jamesorry/WiseTech-Dormitory_Manage_System/README.md

# WiseTech-Dormitory_Manage_System
鴻績-宿舍管理系統
