jamesorry/WiseTech-Dormitory_Manage_System/doc/1637031387367.jpg

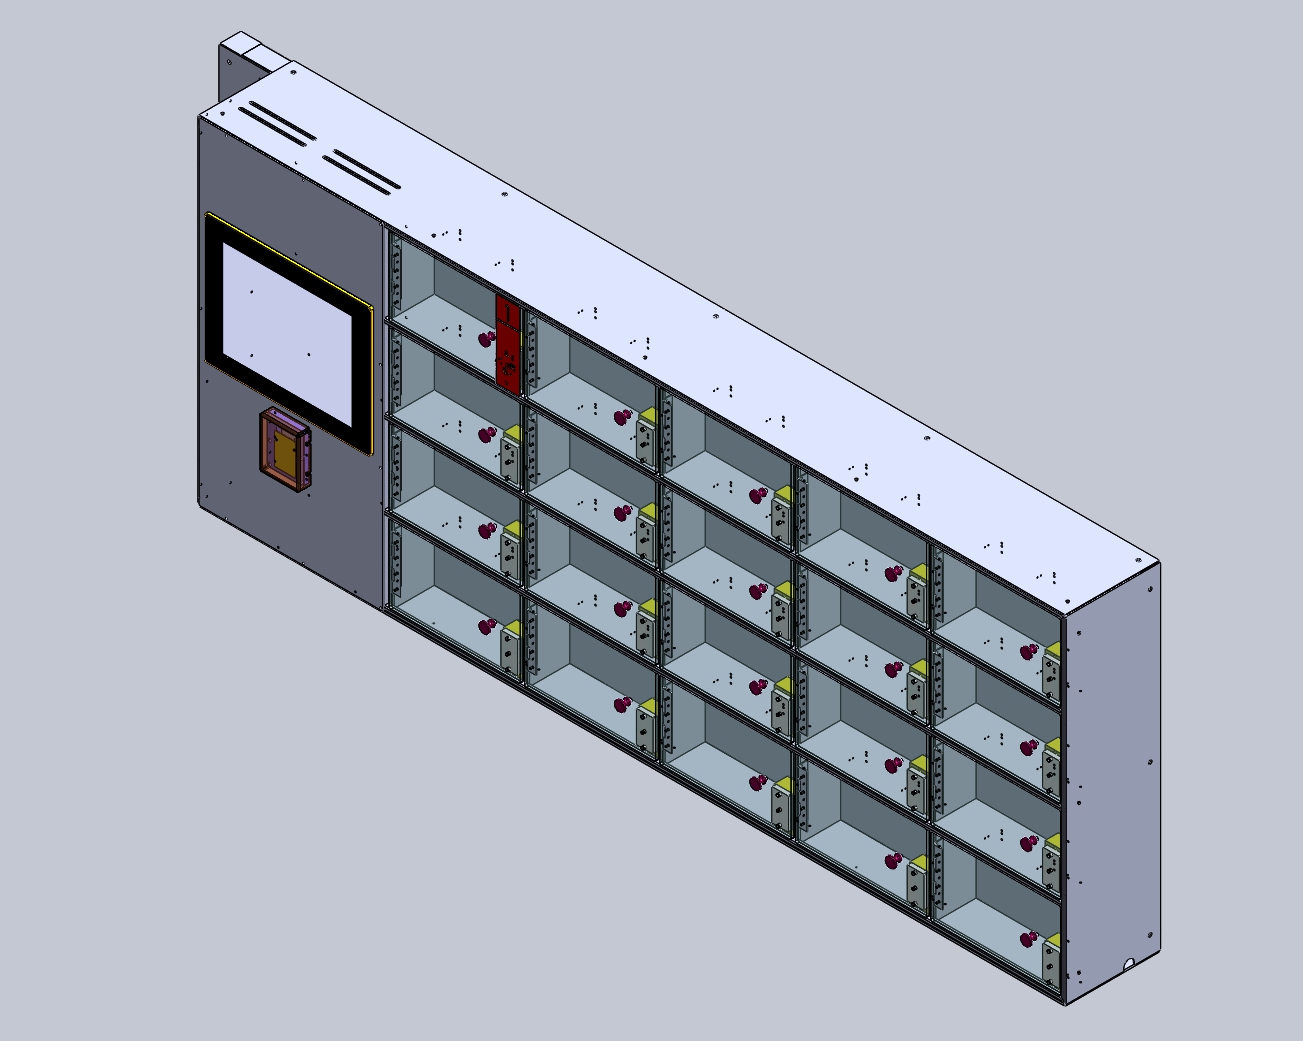
doc/1637031387367.jpg
