jamesorry/WiseTech-Dormitory_Manage_System/doc/1637031412249.jpg

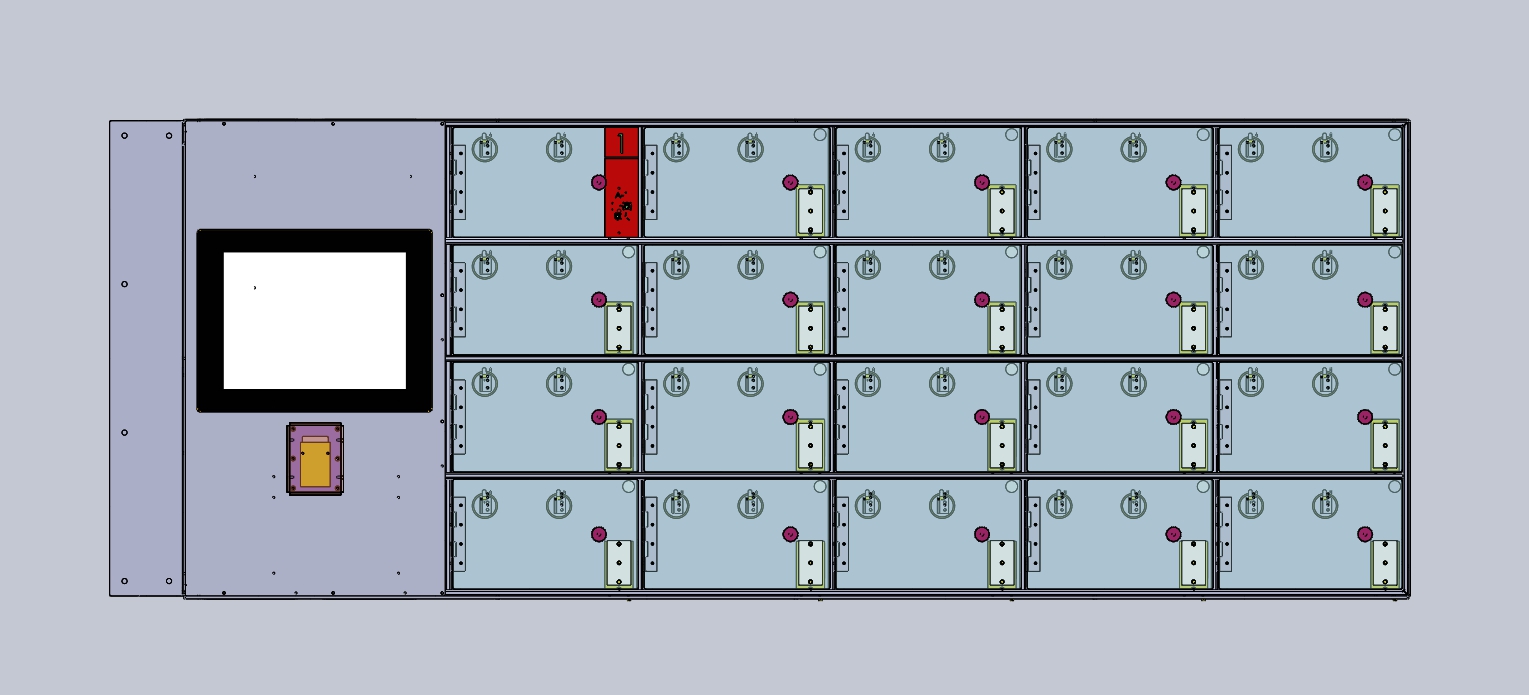
doc/1637031412249.jpg
