jamesorry/WiseTech-Dormitory_Manage_System/doc/1637031450230.jpg

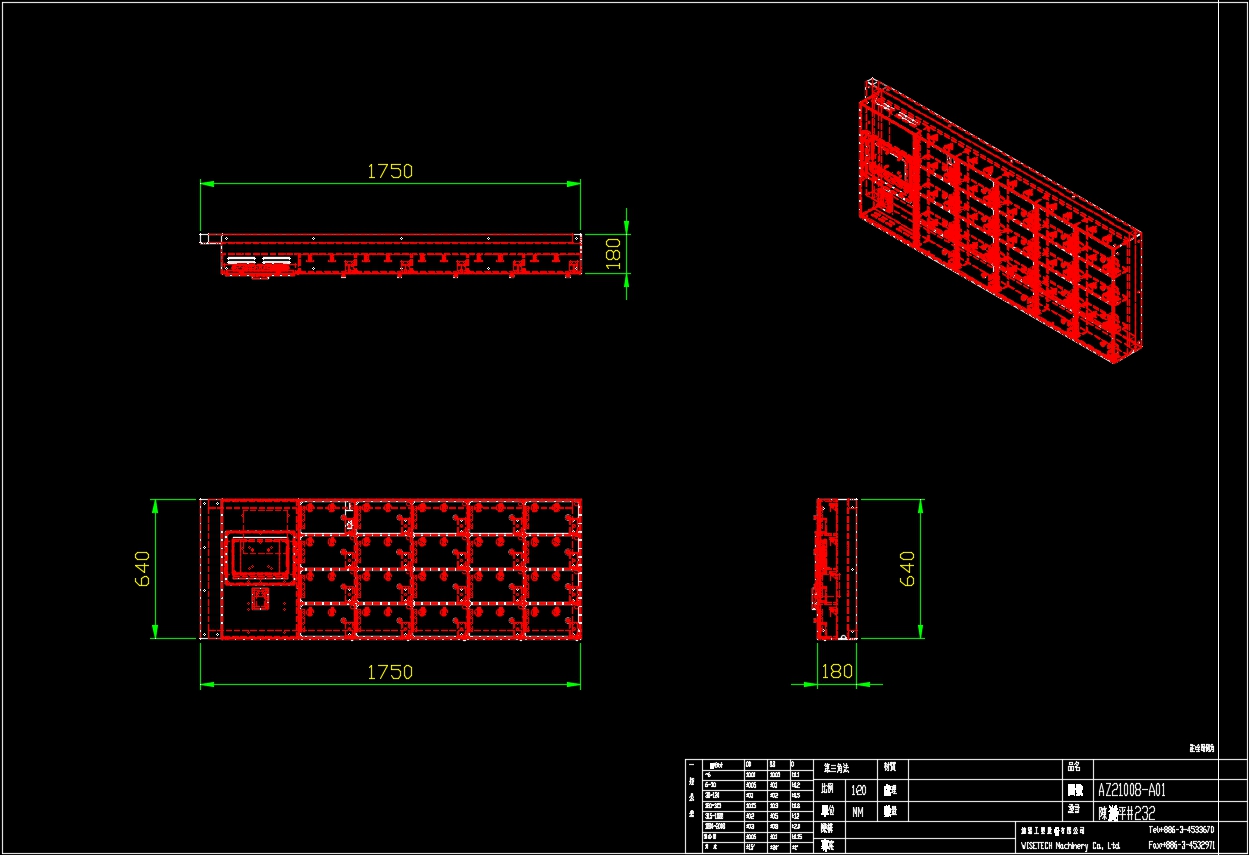
doc/1637031450230.jpg
