jamesorry/WiseTech-Dormitory_Manage_System/doc/Marco/2021-11-22 23-22-35.gif

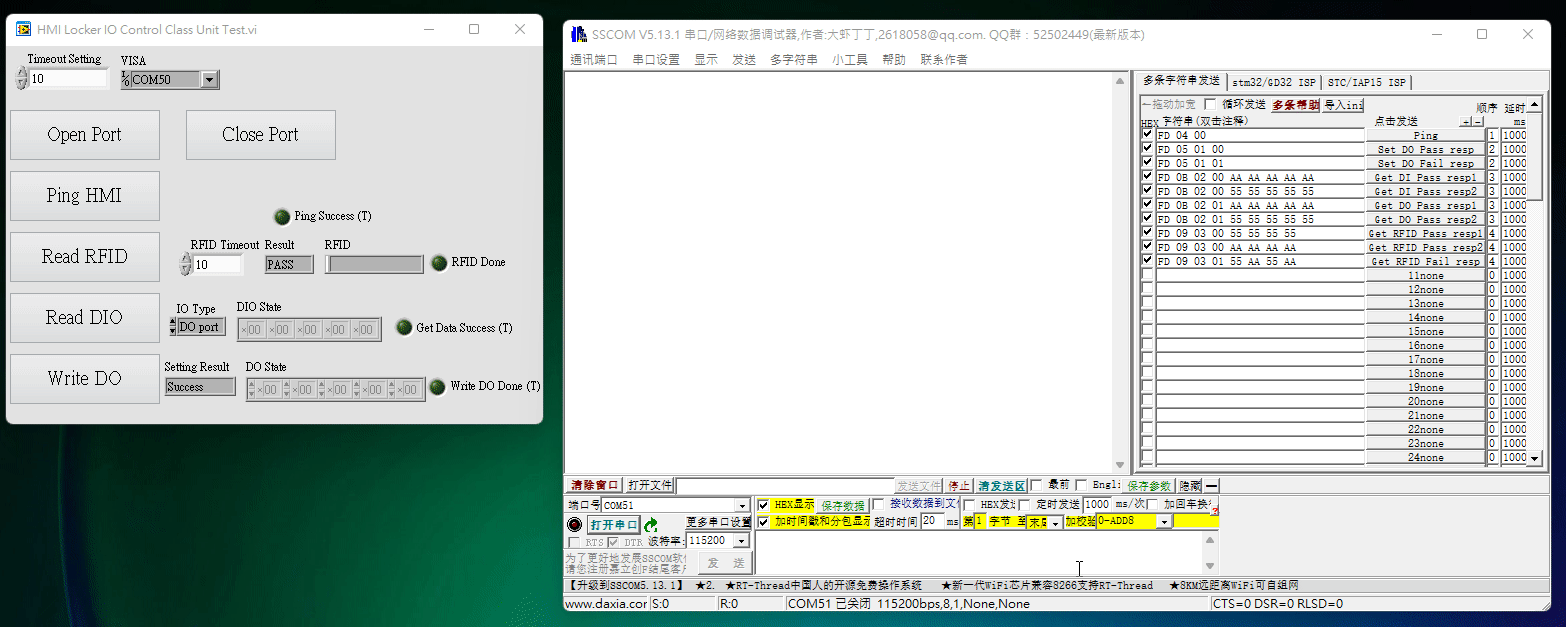
doc/Marco/2021-11-22 23-22-35.gif
