jamesorry/WiseTech-Dormitory_Manage_System/doc/messageImage_1637564319022.jpg

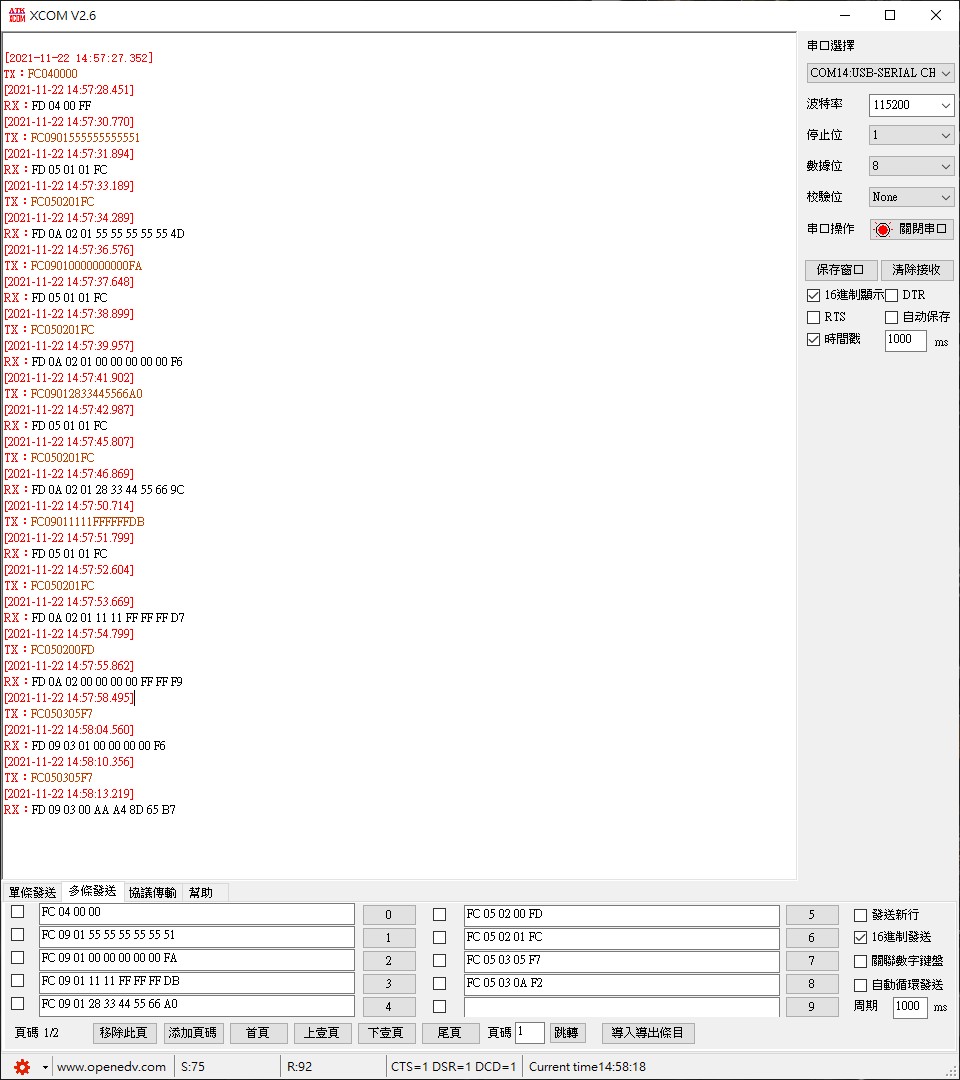
doc/messageImage_1637564319022.jpg
