jamesorry/WiseTech-Dormitory_Manage_System/doc/初步流程規劃圖.jpg

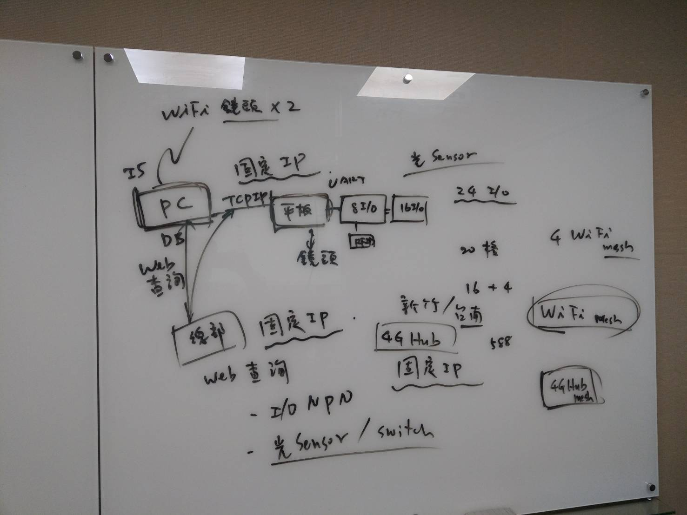
doc/初步流程規劃圖.jpg
