jamesorry/WiseTech-Dormitory_Manage_System/doc/鴻績-宿舍管理HMI IO定義.xls

HMI In |  | Sensor/Switch | 備註 | HMI Out |  | Sensor/Switch | 備註 | 配線注意事項
J12.1 PV | DC+ |  |  | J14.1 GND | GND |  |  | 電磁鎖的規格是 DC12V
J12.2 IN 0 | DI_0 | 宿舍1_key1 | 宿舍1 | J14.2 OUT 0 | DO_0 | 宿舍1_磁扣 | 宿舍1 | HMI 8 in/8 out (NPN)
J12.3 IN 1 | DI_1 | 宿舍1_key2 | 宿舍1 | J14.3 OUT 1 | DO_1 | 宿舍2_磁扣 | 宿舍2 | HMI延伸模組 16 in/ 16 out (NPN) 兩組
J12.4 IN 2 | DI_2 | 宿舍2_key1 | 宿舍2 | J14.4 OUT 2 | DO_2 | 宿舍3_磁扣 | 宿舍3 | RFID模組-特規
J12.5 IN 3 | DI_3 | 宿舍2_key2 | 宿舍2 | J14.5 OUT 3 | DO_3 | 宿舍4_磁扣 | 宿舍4
J12.6 IN 4 | DI_4 | 宿舍3_key1 | 宿舍3 | J14.6 OUT 4 | DO_4 | 宿舍5_磁扣 | 宿舍5
J12.7 IN 5 | DI_5 | 宿舍3_key2 | 宿舍3 | J14.7 OUT 5 | DO_5 | 宿舍6_磁扣 | 宿舍6
J12.8 IN 6 | DI_6 | 宿舍4_key1 | 宿舍4 | J14.8 OUT 6 | DO_6 | 宿舍7_磁扣 | 宿舍7
J12.9 IN 7 | DI_7 | 宿舍4_key2 | 宿舍4 | J14.9 OUT 7 | DO_7 | 宿舍8_磁扣 | 宿舍8
J12.10 GND | GND |  |  | J14.10 PV | DC+
Ext0 In |  | Sensor/Switch | 備註 | Ext0 Out |  | Sensor/Switch | 備註
J3.1 PV | DC+ |  |  | J6.1 GND | GND
J3.2 IN 0 | DI_8 | 宿舍5_key1 | 宿舍5 | J6.2 OUT 0 | DO_8 | 宿舍9_磁扣 | 宿舍9
J3.3 IN 1 | DI_9 | 宿舍5_key2 | 宿舍5 | J6.3 OUT 1 | DO_9 | 宿舍10_磁扣 | 宿舍10
J3.4 IN 2 | DI_10 | 宿舍6_key1 | 宿舍6 | J6.4 OUT 2 | DO_10 | 宿舍11_磁扣 | 宿舍11
J3.5 IN 3 | DI_11 | 宿舍6_key2 | 宿舍6 | J6.5 OUT 3 | DO_11 | 宿舍12_磁扣 | 宿舍12
J3.6 IN 4 | DI_12 | 宿舍7_key1 | 宿舍7 | J6.6 OUT 4 | DO_12 | 宿舍13_磁扣 | 宿舍13
J3.7 IN 5 | DI_13 | 宿舍7_key2 | 宿舍7 | J6.7 OUT 5 | DO_13 | 宿舍14_磁扣 | 宿舍14
J3.8 IN 6 | DI_14 | 宿舍8_key1 | 宿舍8 | J6.8 OUT 6 | DO_14 | 宿舍15_磁扣 | 宿舍15
J3.9 IN 7 | DI_15 | 宿舍8_key2 | 宿舍8 | J6.9 OUT 7 | DO_15 | 宿舍16_磁扣 | 宿舍16
J3.10 IN 8 | DI_16 | 宿舍9_key1 | 宿舍9 | J6.10 OUT 8 | DO_16 | 宿舍17_磁扣 | 宿舍17
J4.1 IN 9 | DI_17 | 宿舍9_key2 | 宿舍9 | J6.1 OUT 9 | DO_17 | 宿舍18_磁扣 | 宿舍18
J4.2 IN 10 | DI_18 | 宿舍10_key1 | 宿舍10 | J6.2 OUT 10 | DO_18 | 宿舍19_磁扣 | 宿舍19
J4.3 IN 11 | DI_19 | 宿舍10_key2 | 宿舍10 | J6.3 OUT 11 | DO_19 | 宿舍20_磁扣 | 宿舍20
J4.4 IN 12 | DI_20 | 宿舍11_key1 | 宿舍11 | J6.4 OUT 12 | DO_20
J4.5 IN 13 | DI_21 | 宿舍11_key2 | 宿舍11 | J6.5 OUT 13 | DO_21
J4.6 IN 14 | DI_22 | 宿舍12_key1 | 宿舍12 | J6.6 OUT 14 | DO_22
J4.7 IN 15 | DI_23 | 宿舍12_key2 | 宿舍12 | J6.7 OUT 15 | DO_23
J4.8 GND | GND |  |  | J6.8 PV | DC+
Ext1 In |  | Sensor/Switch | 備註 | Ext1 Out |  | Sensor/Switch | 備註
J3.1 PV | DC+ |  |  | J6.1 GND | GND
J3.2 IN 0 | DI_24 | 宿舍13_key1 | 宿舍13 | J6.2 OUT 0 | DO_24
J3.3 IN 1 | DI_25 | 宿舍13_key2 | 宿舍13 | J6.3 OUT 1 | DO_25
J3.4 IN 2 | DI_26 | 宿舍14_key1 | 宿舍14 | J6.4 OUT 2 | DO_26
J3.5 IN 3 | DI_27 | 宿舍14_key2 | 宿舍14 | J6.5 OUT 3 | DO_27
J3.6 IN 4 | DI_28 | 宿舍15_key1 | 宿舍15 | J6.6 OUT 4 | DO_28
J3.7 IN 5 | DI_29 | 宿舍15_key2 | 宿舍15 | J6.7 OUT 5 | DO_29
J3.8 IN 6 | DI_30 | 宿舍16_key1 | 宿舍16 | J6.8 OUT 6 | DO_30
J3.9 IN 7 | DI_31 | 宿舍16_key2 | 宿舍16 | J6.9 OUT 7 | DO_31
J3.10 IN 8 | DI_32 | 宿舍17_key1 | 宿舍17 | J6.10 OUT 8 | DO_32
J4.1 IN 9 | DI_33 | 宿舍17_key2 | 宿舍17 | J6.1 OUT 9 | DO_33
J4.2 IN 10 | DI_34 | 宿舍18_key1 | 宿舍18 | J6.2 OUT 10 | DO_34
J4.3 IN 11 | DI_35 | 宿舍18_key2 | 宿舍18 | J6.3 OUT 11 | DO_35
J4.4 IN 12 | DI_36 | 宿舍19_key1 | 宿舍19 | J6.4 OUT 12 | DO_36
J4.5 IN 13 | DI_37 | 宿舍19_key2 | 宿舍19 | J6.5 OUT 13 | DO_37
J4.6 IN 14 | DI_38 | 宿舍20_key1 | 宿舍20 | J6.6 OUT 14 | DO_38
J4.7 IN 15 | DI_39 | 宿舍20_key2 | 宿舍20 | J6.7 OUT 15 | DO_39
J4.8 GND | GND |  |  | J6.8 PV | DC+
