jamesorry/WiseTech-Dormitory_Manage_System/(list of files, cad)

Other CAD files:
doc/AZ21008-A01.DWG
