jamesorry/WiseTech-Dormitory_Manage_System/doc/HMI IO bit map 確認.pdf

T | T | T | T

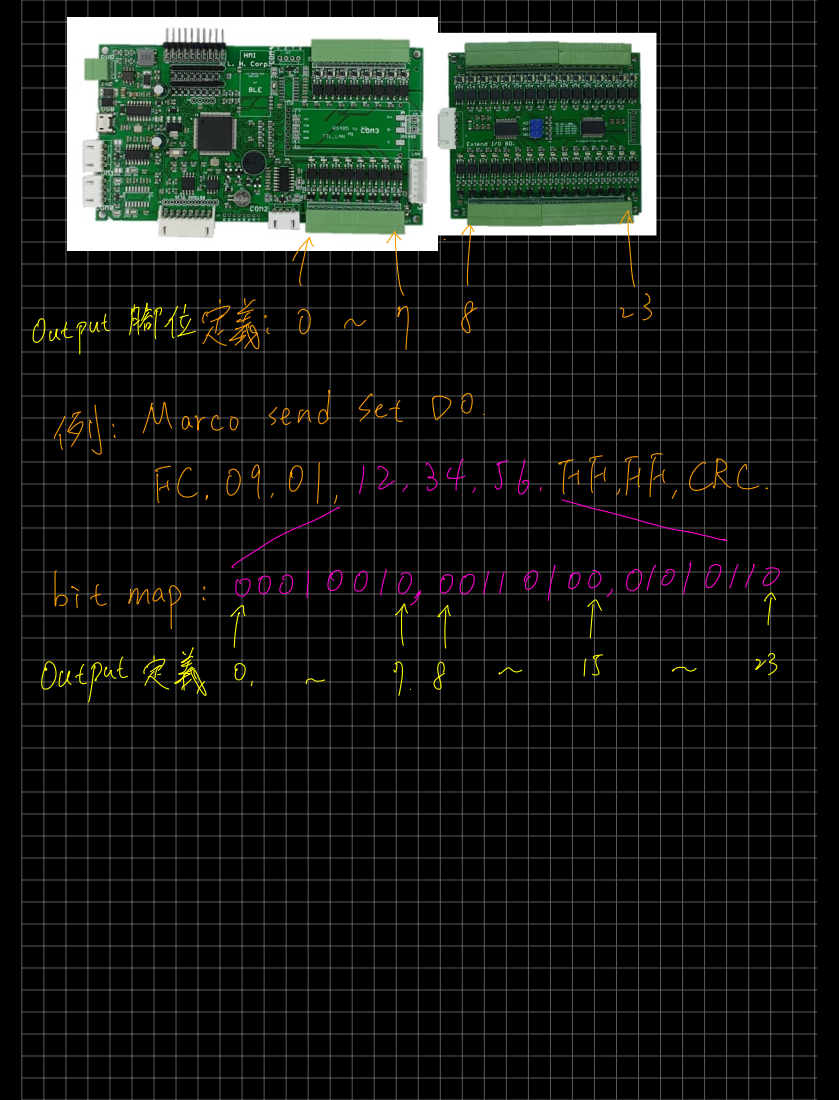
[picture p8: page 1]
output 腳位定義; Output定義

例 | Marco | | send | Set | DO
FC | 09，01，12，34，56 | | | | FF.FF.CI
gT001o | | oonoloo oii | i

C.bitmap
