jamesorry/WiseTech-Dormitory_Manage_System/src/Dormitory_Manage_System/UserCommand.h

#ifndef _USER_COMMAND_H_
#define	_USER_COMMAND_H_

#include "Arduino.h"

typedef struct __CMD {
  const char* cmd;
  void (*func)(void);
} CMD, *PCMD;
void cmd_Trigger_Read_RFID(void);
void cmdInput(void);
void cmdOutput(void);
void cmd_Maindata(void);
void cmd_UpdateEEPROM(void);
void cmd_ClearEEPROM(void);
void resetArduino(void);
void getMicros(void);
void getAdc(void);
void getGpio(void);
void setGpio(void);
void echoOn(void);
void echoOff(void);
void cmd_CodeVer(void);
void showHelp(void);
bool getNextArg(String &arg);

void UserCommand_Task(void);
void UserCommand_Timer(void);
#endif //_USER_COMMAND_H_
