jamesorry/WiseTech-Dormitory_Manage_System/(commit log)

2021-11-12 添加RFID讀取timeout流程
2021-11-19 2021111901
    修改HMI_Command及IO
    [AZ21008-A01.DWG]
2021-12-01 20211201
    Print RFID hex string
2021-12-14 auto read rfid
    [鴻績-宿舍管理HMI IO定義.xls]
2022-02-15 debug hmi cmd port
    [鴻績-宿舍管理HMI IO定義.xls, 鴻績-宿舍管理HMI IO定義_.xls]
2022-02-15 2022021501
    修改bit map
